bnielse6/robotrac/docs/README.md

# Documentation index

The docs are grouped by what you want to do with them. Start with the folder that matches your question.

| Folder | Question it answers | Contents |
|---|---|---|
| `design/` | What is the robot, and why is it built this way? | Intended behavior, hardware choices, electrical plan, decision log |
| `software/` | How does the code work? | Message contract, Supervisor code, simulator, ESP32 firmware |
| `project/` | Where are we, and how do I run things? | Status, decisions, next steps, setup and troubleshooting |
| `planning/` | How was navigation and path planning worked out? | Findings for presenting, brainstorm records, navigation research, figures, sample schematics |
| `diagrams/` | (assets) Flowcharts and state charts | `.mmd` sources and `.png` renders, used by `design/complete_system_guide.md` |
| `original-flowcharts/` | (assets) The original hand-drawn flowcharts | Kept for reference |

## design/

| Document | About |
|---|---|
| `design/complete_system_guide.md` | **Source of truth for robot behavior**: subsystems, Supervisor state chart, every error (E1 to E10), decisions, open questions |
| `design/fault_policy.md` | One-page version of the error rules |
| `design/hardware_architecture.md` | Decision record: Pi 5 (8 GB), ESP32, USB serial, hardware E-stop |
| `design/electrical_recommendations.md` | Recommended controllers, power, E-stop, drivers, noise handling, bring-up order. A recommendation, not yet a decision |
| `design/pin_map.md` | Draft pin map: every signal, pin count, location and noise column, to decide one ESP32 or more |
| `design/design_concept.md` | Long-term design reference: requirements, architecture, sensing concept, and the design decision log (D1 and up) |

## software/

| Document | About |
|---|---|
| `software/message_schema.md` | The contract between the Pi and the ESP32, including camera questions and every departure from the system guide |
| `software/supervisor_code_guide.md` | A tour of the Python code in `supervisor/` |
| `software/simulator_guide.md` | What the simulator proves and does not, and how to use the dashboard |
| `software/firmware_guide.md` | The ESP32 firmware: structure, building, safety behavior, bring-up stages |

## project/

| Document | About |
|---|---|
| `project/next_steps.md` | Status, decision log, open questions, known gaps, roadmap in phases |
| `project/setup_guide.md` | Tools installed on this PC, commands, where files go, troubleshooting, Pi setup outline |

## planning/

| Document | About |
|---|---|
| `planning/path_planning_findings.md` | **Path planning findings, written for presenting**: approach, results with figures, accuracy analysis, what is not done and what is only assumed |
| `planning/brainstorm-2026-11-09.md` | Session notes: planner, deck and fastening pattern, SVG preview, Supervisor communication, one versus two ESP32s |
| `planning/navigation/navigation-notes.md` | The owner's original navigation notes |
| `planning/navigation/navigation-brainstorm-2026-11-04.md` | The discussion, buy list and bench test plan |
| `planning/navigation/navigation-plan-2026-11-04.md` | Conclusions, what is next, open questions |
| `planning/navigation/` (other files) | Reference material: DensDeck installation guide, fastening report and pattern |
| `planning/figures/` | Figures generated by the planner for the findings document |
| `planning/samples/` | Sample roof schematics (SVG, DXF) for the schematic reader |

## Where to put a new document

- Describes what the robot does or why a hardware choice was made: `design/`.
- Describes code, messages or the simulator: `software/`, and update the matching guide when behavior changes.
- Status, decisions to date, setup or how-to: `project/`.
- A dated session record, an analysis or research: `planning/`, with the date in the file name.
- Add a row to the table above and to the root `README.md` if it is a main document.
