bnielse6/robotrac/docs/original-flowcharts/Fastning Process.png

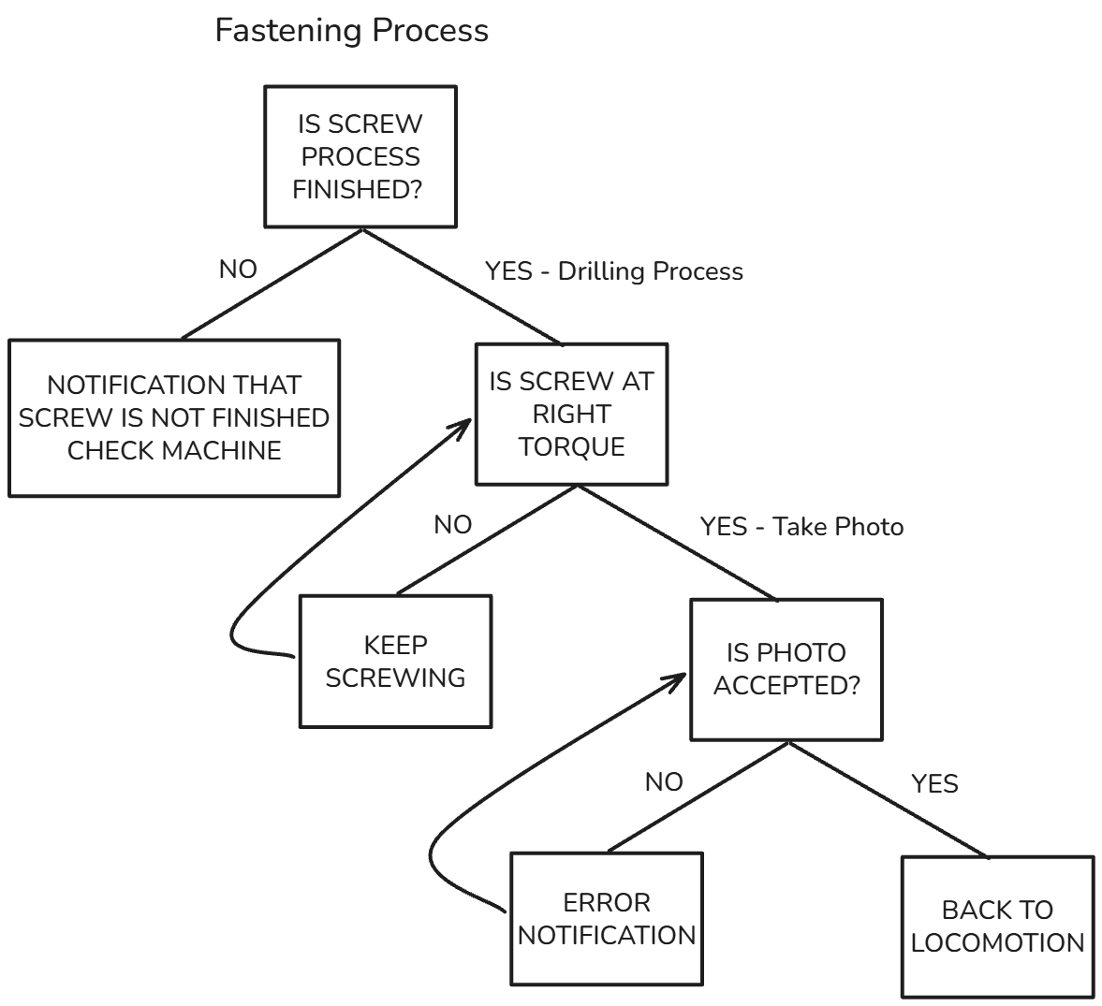
docs/original-flowcharts/Fastning Process.png
