bnielse6/robotrac/docs/original-flowcharts/Locomotion_Driving_Straight.png

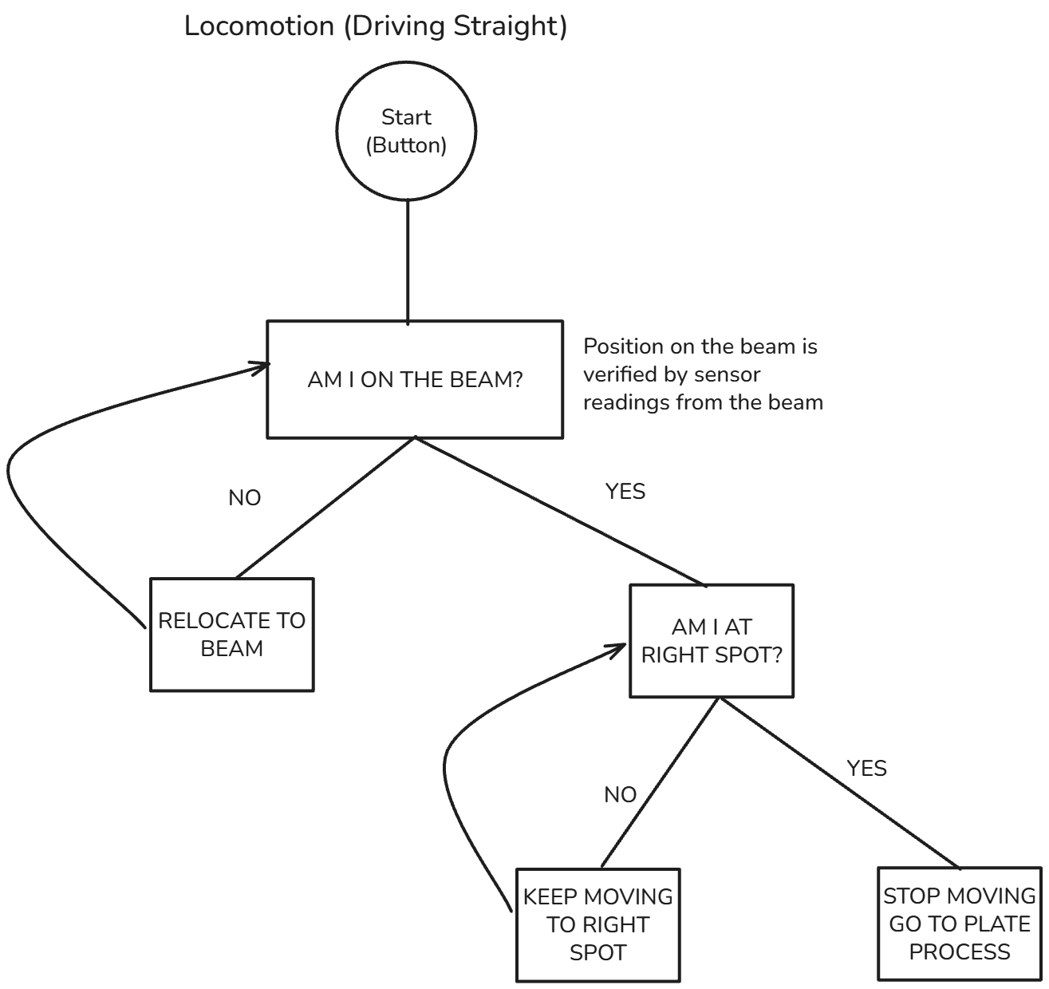
docs/original-flowcharts/Locomotion_Driving_Straight.png
