bnielse6/robotrac/docs/original-flowcharts/Locomotion_Driving_Turning.png

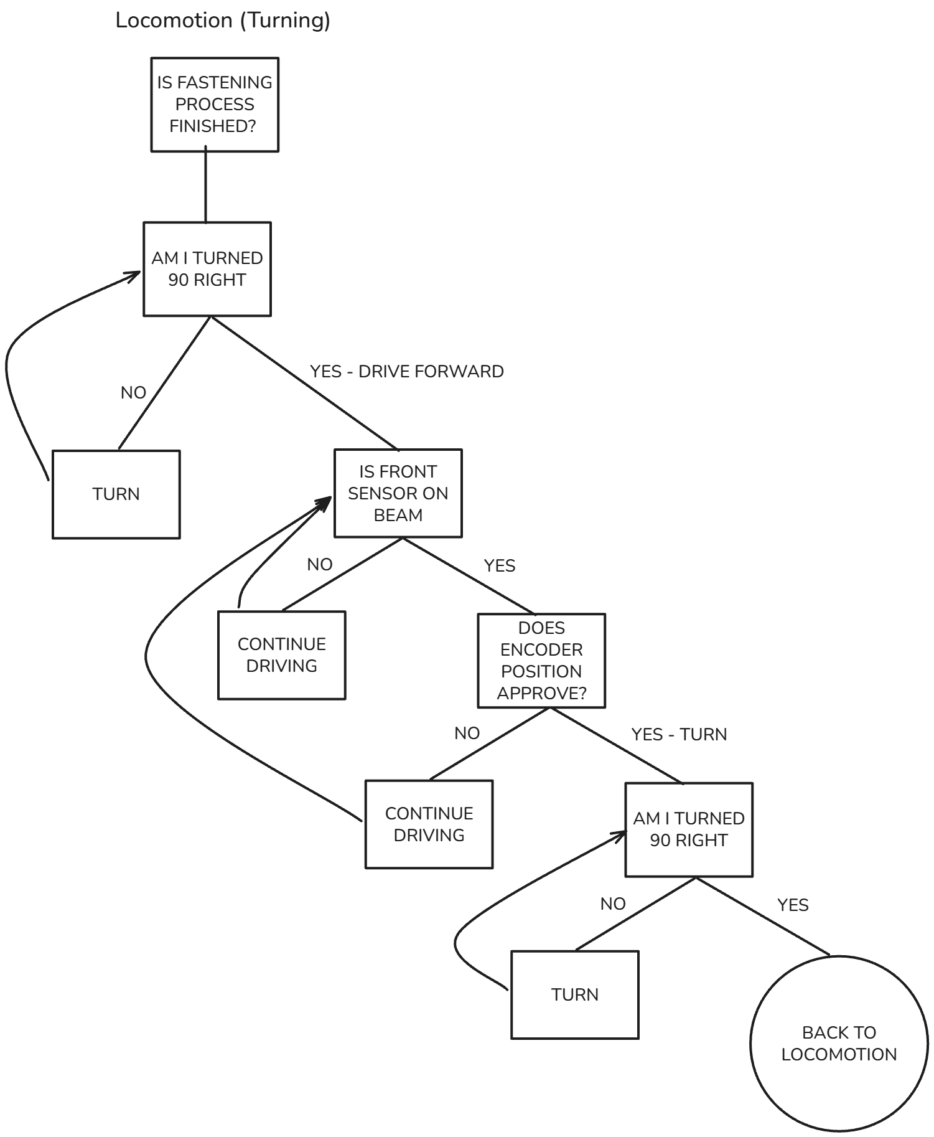
docs/original-flowcharts/Locomotion_Driving_Turning.png
