bnielse6/robotrac/docs/original-flowcharts/Plate Process.png

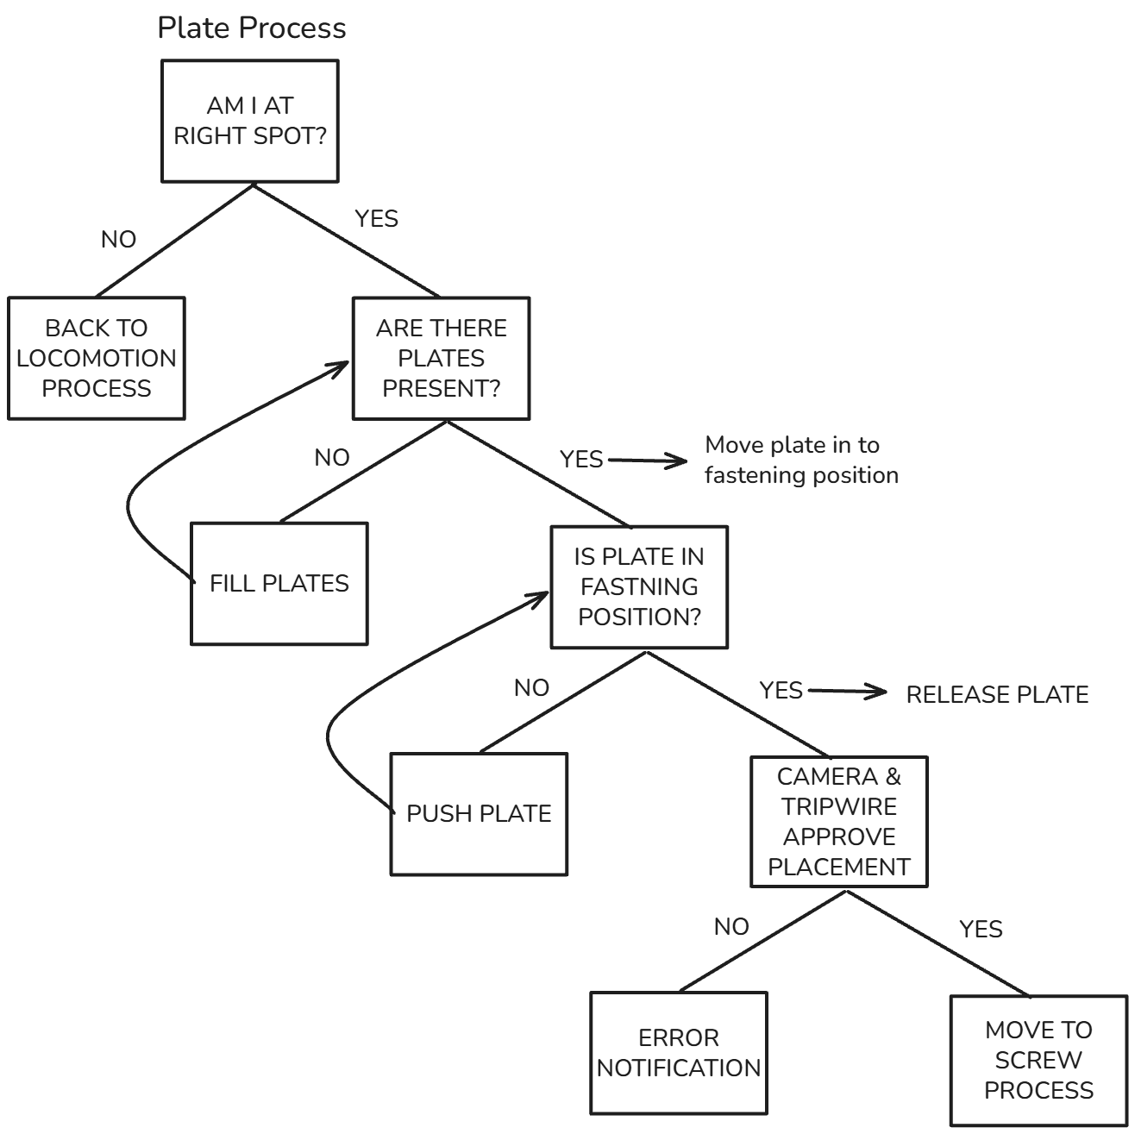
docs/original-flowcharts/Plate Process.png
