bnielse6/robotrac/docs/original-flowcharts/Screw Process.png

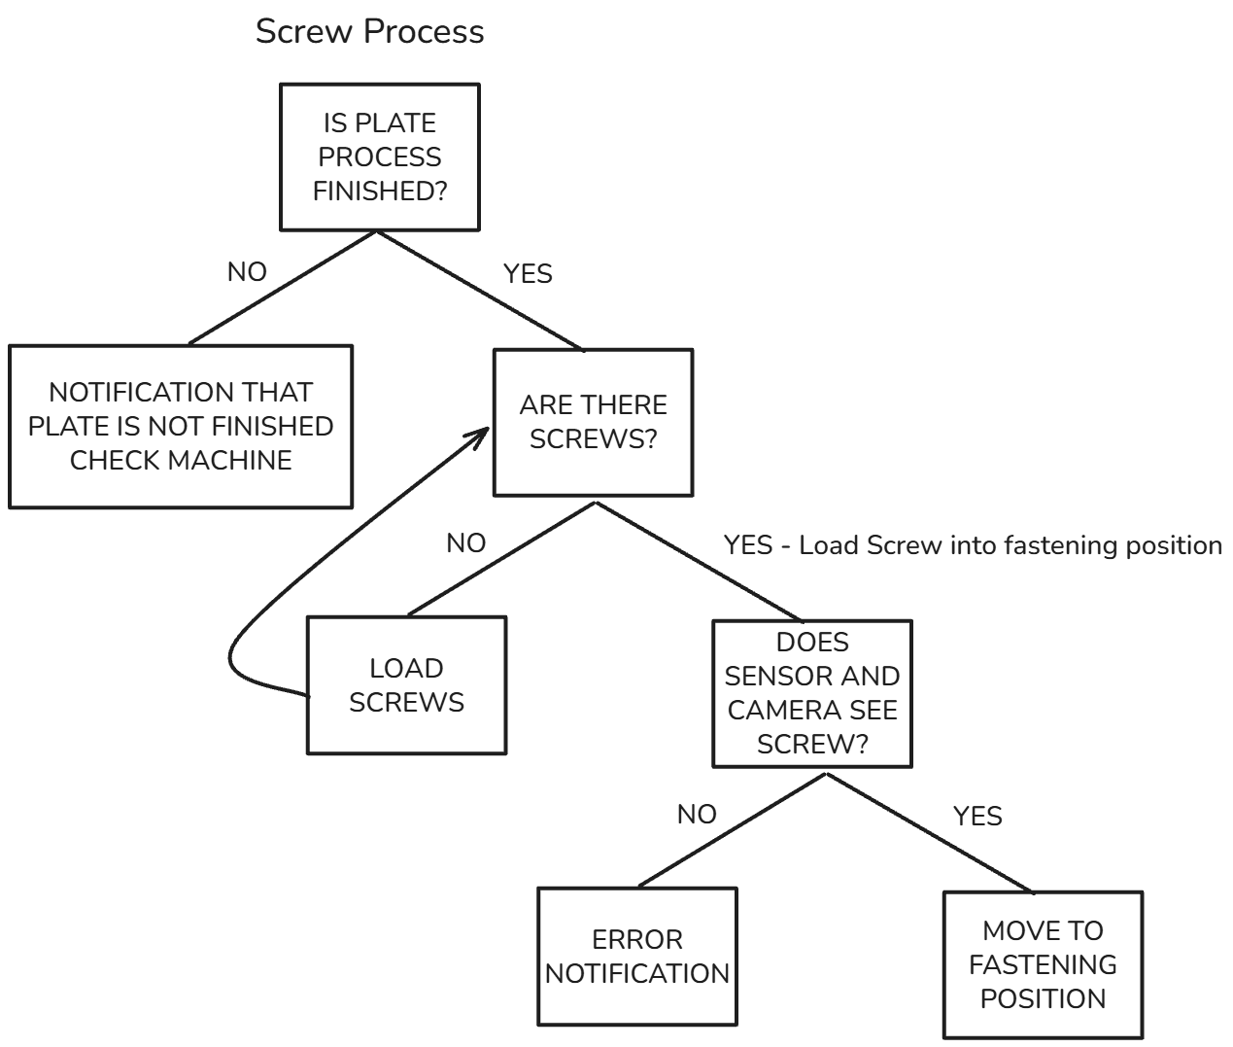
docs/original-flowcharts/Screw Process.png
