bnielse6/robotrac/docs/planning/navigation/Fastning Pattern.jpg

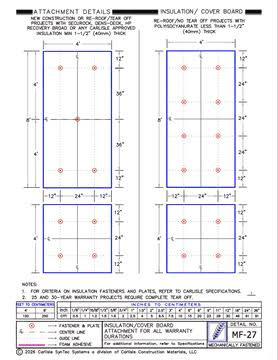
docs/planning/navigation/Fastning Pattern.jpg
