bnielse6/robotrac/CAD/Chassis Design/AssemTracks.SLDASM

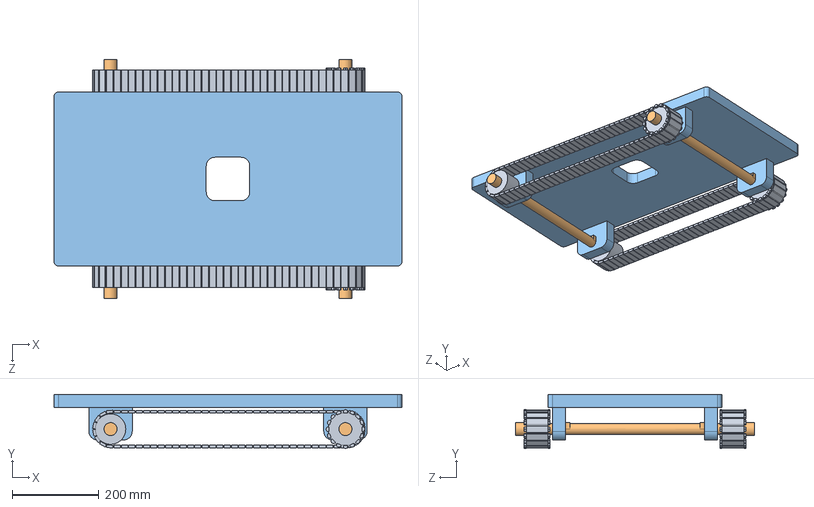
[picture p14: CAD file, 2026-11-12]
CAD/Chassis Design/AssemTracks.SLDASM
800.0 x 125.0 x 550.0 mm
Frame
Axel x 2
Track and Wheel x 2
