bnielse6/robotrac/CAD/Drilling System/Drill_System_Assembly.SLDASM

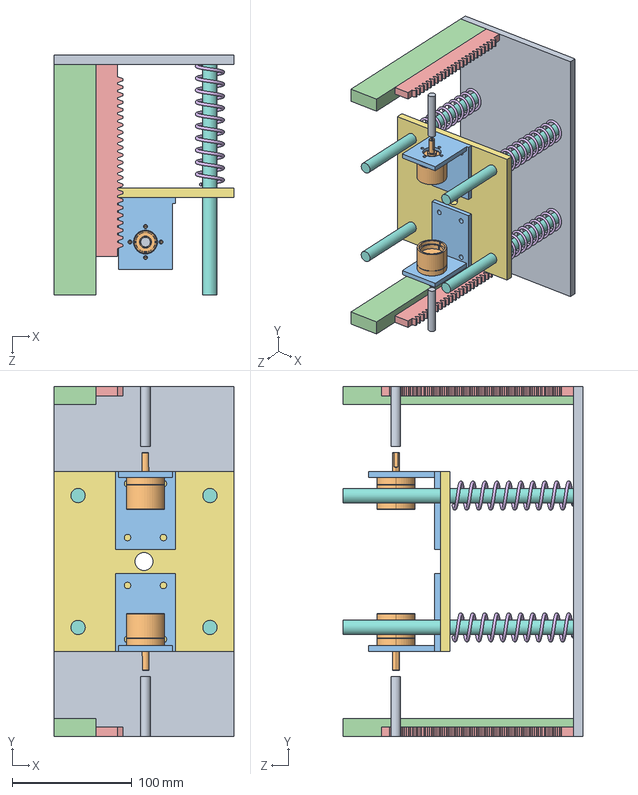
[picture p15: CAD file, 2026-11-12]
CAD/Drilling System/Drill_System_Assembly.SLDASM
150.0 x 292.0 x 200.0 mm
Fixed_Bottom_Plate
Vertical_Guide_Rod x 4
Moving_Upper_Plate
Compression_Spring x 4
Vertical_Gear_Rack x 2
Stationary_Rack_Support x 2
Compact_Motor_Mount x 2
Motor3 x 2
Pinion_Drive_Shaft x 2
