bnielse6/robotrac/CAD/Drilling System/Compact_Motor_Mount.SLDPRT

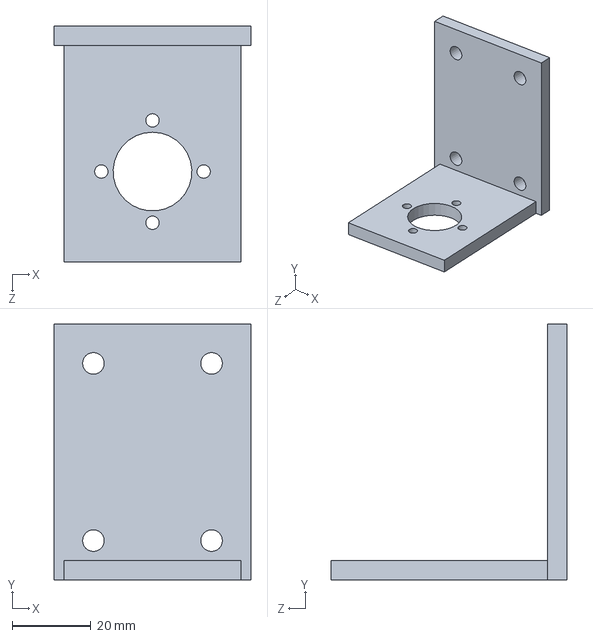
[picture p16: CAD file, 2026-11-12]
CAD/Drilling System/Compact_Motor_Mount.SLDPRT
50.0 x 65.0 x 60.0 mm
