bnielse6/robotrac/CAD/Chassis Design/Track and Wheel.SLDPRT

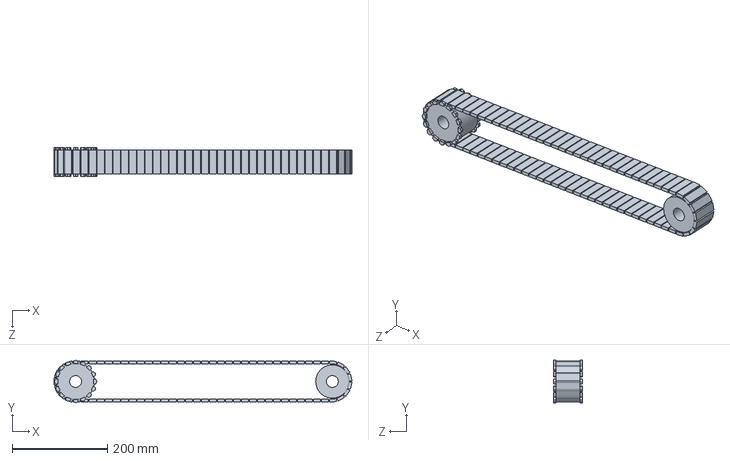
[picture p17: CAD file, 2026-11-12]
CAD/Chassis Design/Track and Wheel.SLDPRT
626.8 x 90.0 x 60.0 mm
