bnielse6/robotrac/CAD/Drilling System/Motor3.SLDPRT

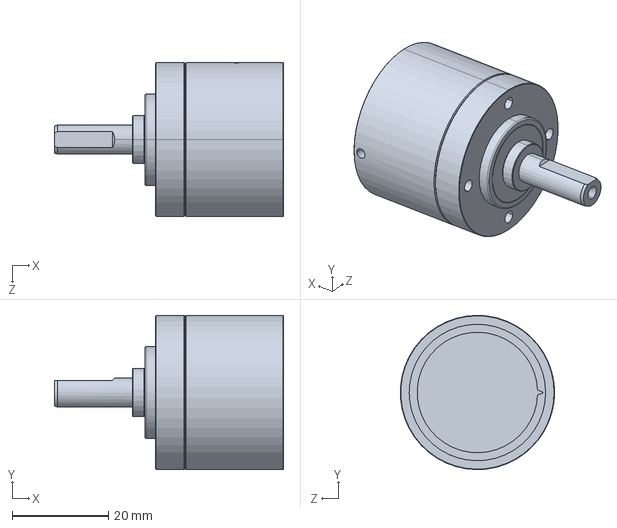
[picture p18: CAD file, 2026-11-12]
CAD/Drilling System/Motor3.SLDPRT
47.5 x 32.0 x 32.0 mm
