bnielse6/robotrac/CAD/Chassis Design/Axel.SLDPRT

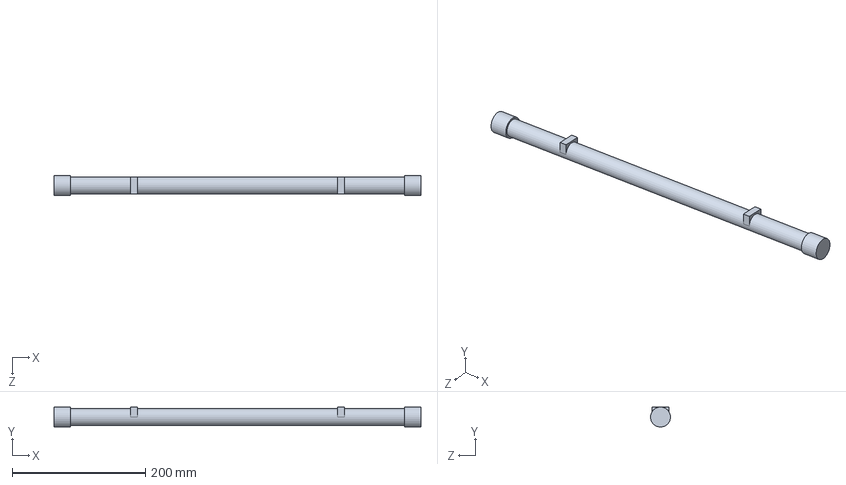
[picture p19: CAD file, 2026-11-12]
CAD/Chassis Design/Axel.SLDPRT
550.0 x 29.9 x 30.0 mm
