bnielse6/robotrac/CAD/Drilling System/Pinion_Drive_Shaft.SLDPRT

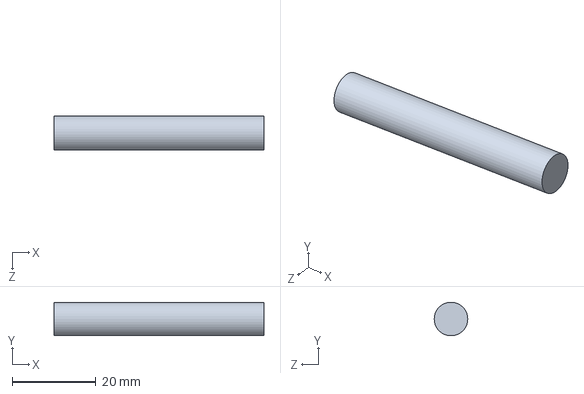
[picture p20: CAD file, 2026-11-12]
CAD/Drilling System/Pinion_Drive_Shaft.SLDPRT
50.0 x 7.97 x 8.00 mm
