bnielse6/robotrac/CAD/Chassis Design/Frame.SLDPRT

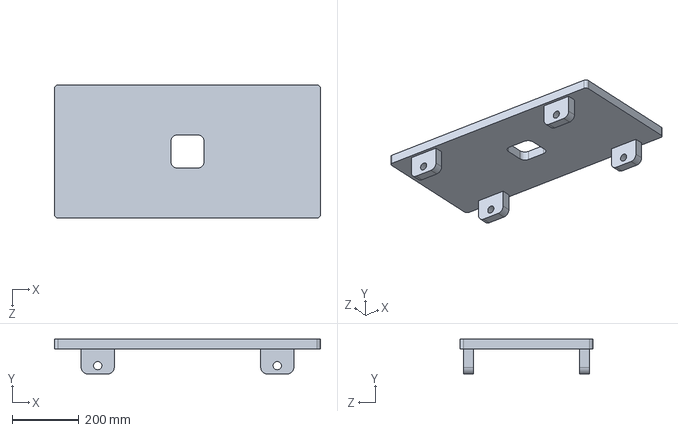
[picture p21: CAD file, 2026-11-12]
CAD/Chassis Design/Frame.SLDPRT
800.0 x 105.0 x 400.0 mm
