bnielse6/robotrac/CAD/Drilling System/Moving_Upper_Plate.SLDPRT

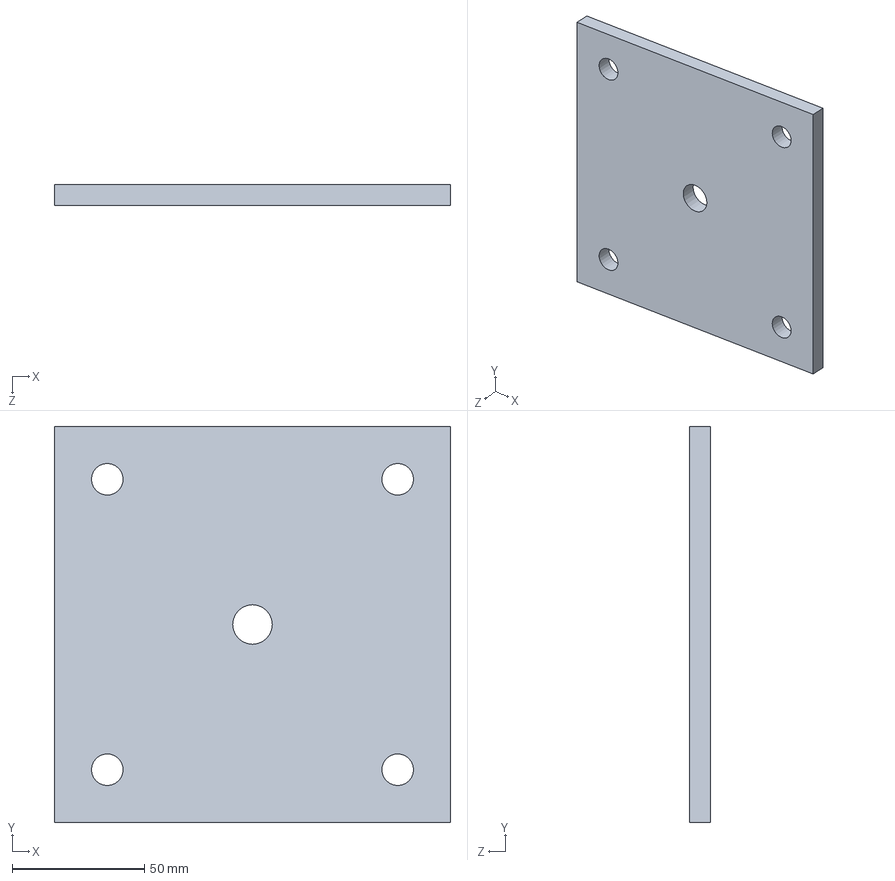
[picture p22: CAD file, 2026-11-12]
CAD/Drilling System/Moving_Upper_Plate.SLDPRT
150.0 x 150.0 x 8.00 mm
