bnielse6/robotrac/CAD/Drilling System/Vertical_Guide_Rod.SLDPRT

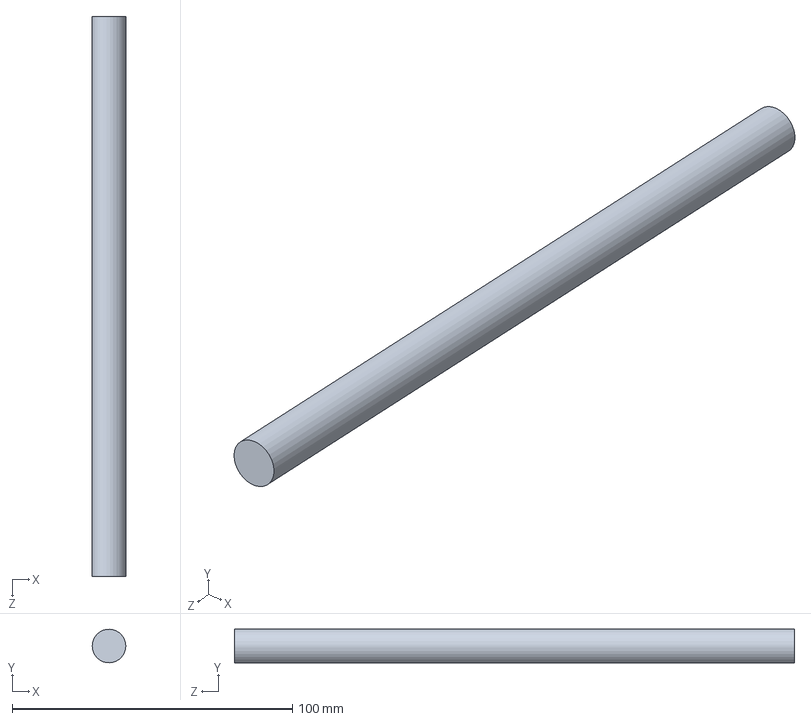
[picture p23: CAD file, 2026-11-12]
CAD/Drilling System/Vertical_Guide_Rod.SLDPRT
12.0 x 12.0 x 200.0 mm
