bnielse6/robotrac/CAD/Drilling System/Stationary_Rack_Support.SLDPRT

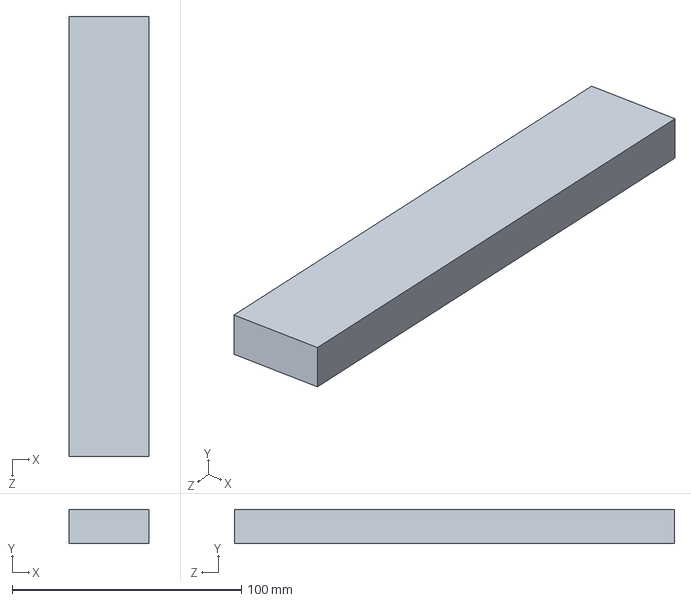
[picture p24: CAD file, 2026-11-12]
CAD/Drilling System/Stationary_Rack_Support.SLDPRT
35.0 x 15.0 x 192.0 mm
