bnielse6/robotrac/CAD/Drilling System/Compression_Spring.SLDPRT

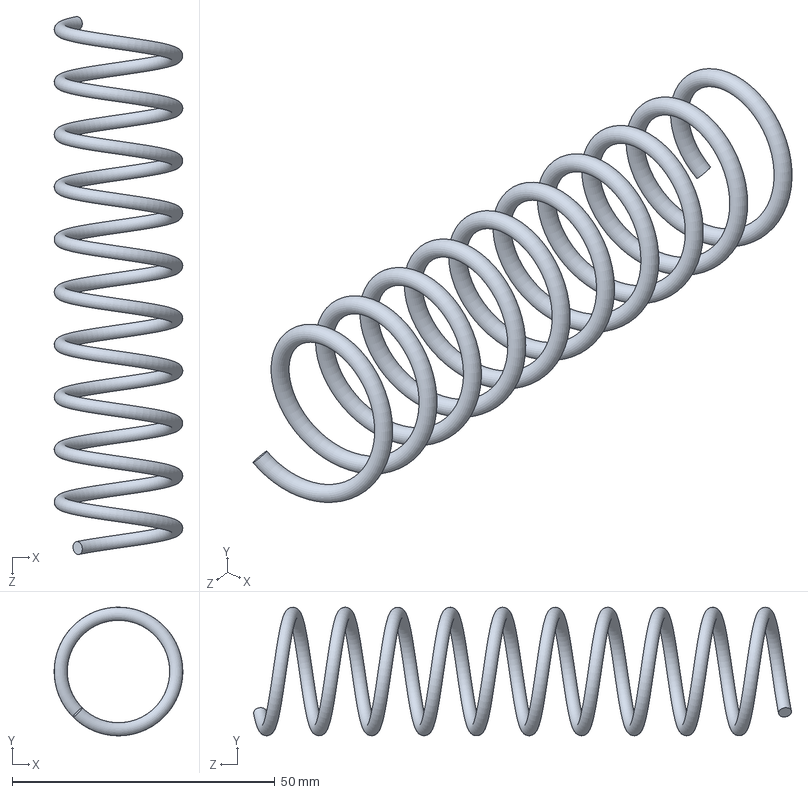
[picture p25: CAD file, 2026-11-12]
CAD/Drilling System/Compression_Spring.SLDPRT
24.5 x 24.5 x 102.5 mm
