bnielse6/robotrac/CAD/Drilling System/Fixed_Bottom_Plate.SLDPRT

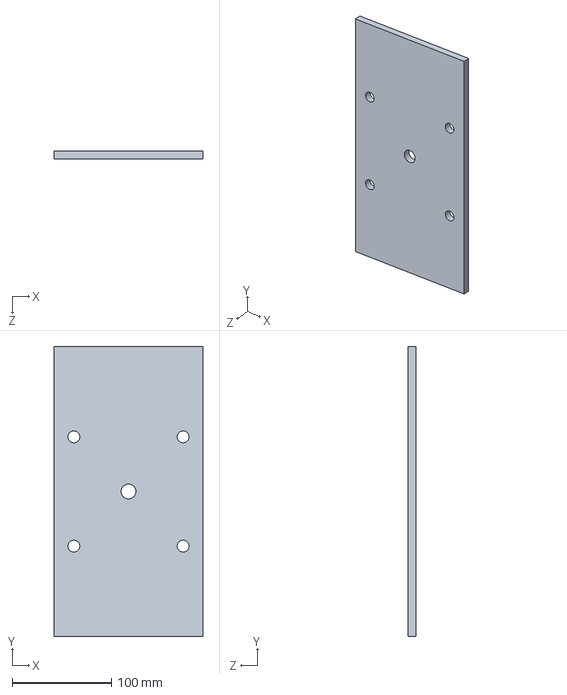
[picture p26: CAD file, 2026-11-12]
CAD/Drilling System/Fixed_Bottom_Plate.SLDPRT
150.0 x 292.0 x 8.00 mm
