bnielse6/robotrac/CAD/Drilling System/Vertical_Gear_Rack.SLDPRT

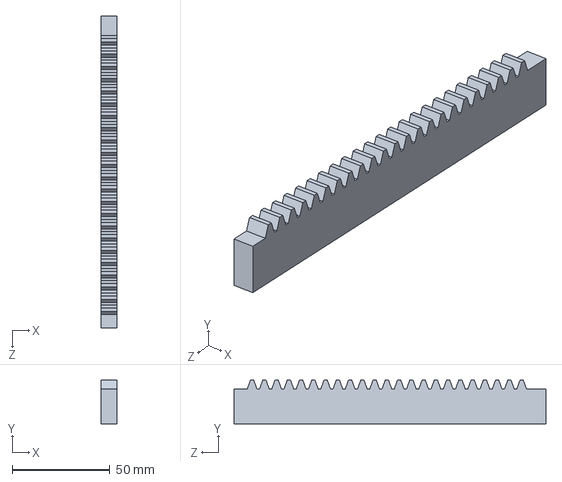
[picture p27: CAD file, 2026-11-12]
CAD/Drilling System/Vertical_Gear_Rack.SLDPRT
8.00 x 22.5 x 160.0 mm
