bnielse6/robotrac/CAD/Drilling System/Ruland_mclx-8-6-x.SLDASM

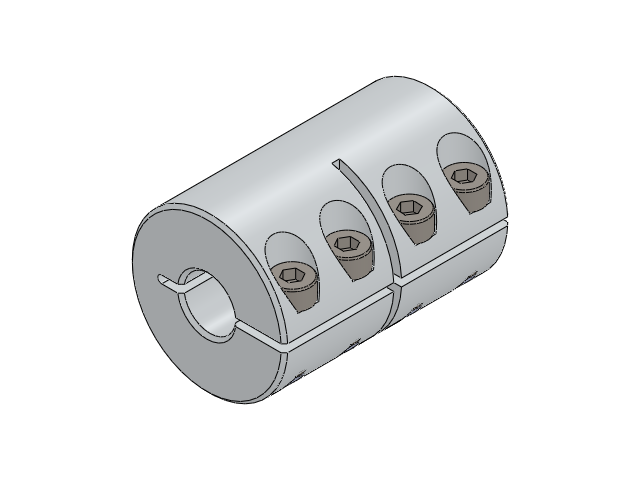
[picture p28: CAD file, 2026-11-12]
CAD/Drilling System/Ruland_mclx-8-6-x.SLDASM
Clamp Style Metric_MCLX-8-6-X-C
Metric Socket Head Cap Screws 1C_CFM3_10 x 4
