bnielse6/robotrac/(list of files, cad)

Other CAD files:
docs/planning/samples/sample_schematic_L.dxf
CAD/Drilling System/Shaft_Coupling.SLDPRT
CAD/Drilling System/Ruland_Metric Socket Head Cap Screws 1C_CFM3_10.SLDPRT
CAD/Drilling System/166155_GP32A-1st.SLDPRT
