bnielse6/robotrac/docs/planning/navigation/Fastning Report.pdf

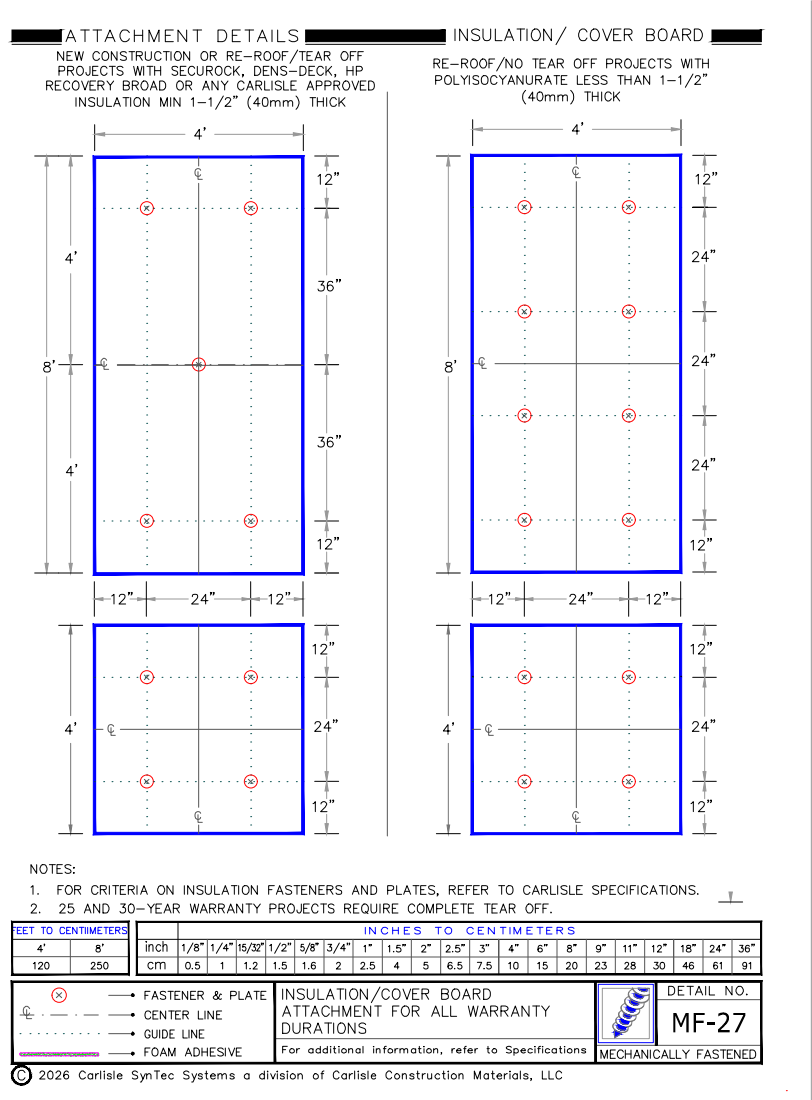
[picture p48: page 1]
