bnielse6/robotrac/(commit log)

2026-11-04 Reorganize into docs/ with diagrams/ and original-flowcharts/ subfolders
    Remove the duplicate numbered docs copy and update path references.
2026-11-04 Add navigation plan, design concept doc and sensor test plan
    Rename the navigation brainstorm to carry its date, record the diamond
    sensor array idea, decisions, buy list and bench test plan, and start
    docs/design_concept.md as the living design reference.
2026-11-10 Add roof layout planner, SVG preview, pin map and 2026-11-09 brainstorm
    - planner.py: whole 4x8 ft boards, Carlisle MF-27 fastener pattern (5 or 8 per
    board), crest snap, lawnmower rows with crest counts
    - planner_svg.py and plan_preview.py: scaled SVG preview with named layers
    - 22 new tests (109 total)
    - pin_map.md draft, brainstorm-2026-11-09.md, decisions D14 to D18 in
    design_concept.md, next_steps question 10 updated to a two-ESP32 direction
    - Densdeck installation guide and MF-27 fastening pattern added under docs/navigation
    [planner.py, planner_svg.py]
2026-11-10 Path planning basis: drawn and imported roofs, run-on strips, fine positioning, accuracy model
    Planner
    - Plan any roof outline (drawn polygon or SVG/DXF schematic), keeping only whole
    4x8 ft boards that fit; 13-shape library; 4x4 board option removed
    - Real crest positions from a schematic replace the assumed flute pitch
    - Every strip is driven forwards over the same stretch: it runs on past its last
    screw to the next strip's first-screw level and turns there (turn_style run-out);
    turning at the last screw and reversing stays as an option
    - Route carries signed distances (negative = reverse) plus the crest count, sideways
    gap and run-out for each turn; layout_to_route feeds the Super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
    [sample_schematic_L.dxf]
2026-11-10 Reorganize docs into design, software, project and planning folders
    Move the flat docs into purpose-based folders, add docs/README.md as an
    index, and update all cross-references, READMEs, CLAUDE.md and code comments.
    [sample_schematic_L.dxf]
2026-11-12 Prelim Chassis CAD Upload
    [AssemTracks.SLDASM, Axel.SLDPRT, Frame.SLDPRT, Track and Wheel.SLDPRT]
